NG0117/-/接腳圖/mega pro_pin.jpg

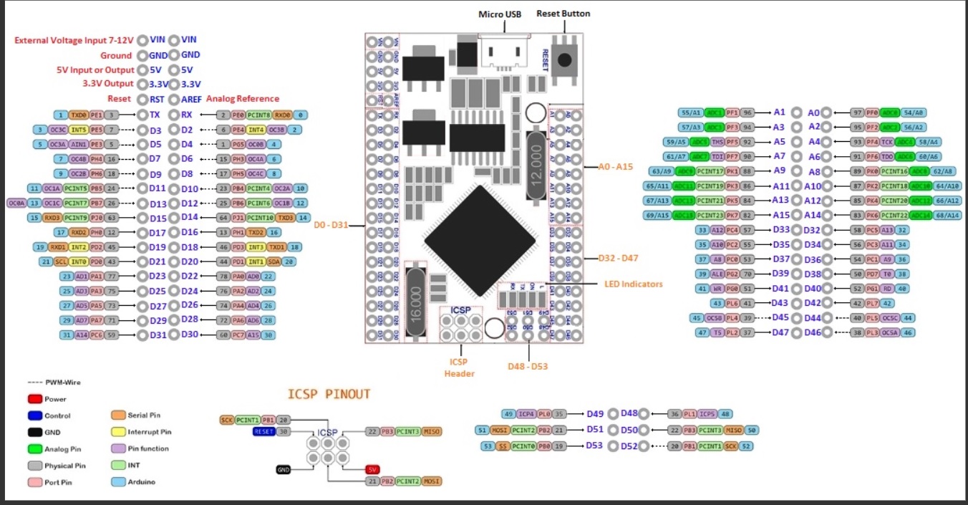
接腳圖/mega pro_pin.jpg
