NG0117/-/接腳圖/ESP32接腳圖.jpg

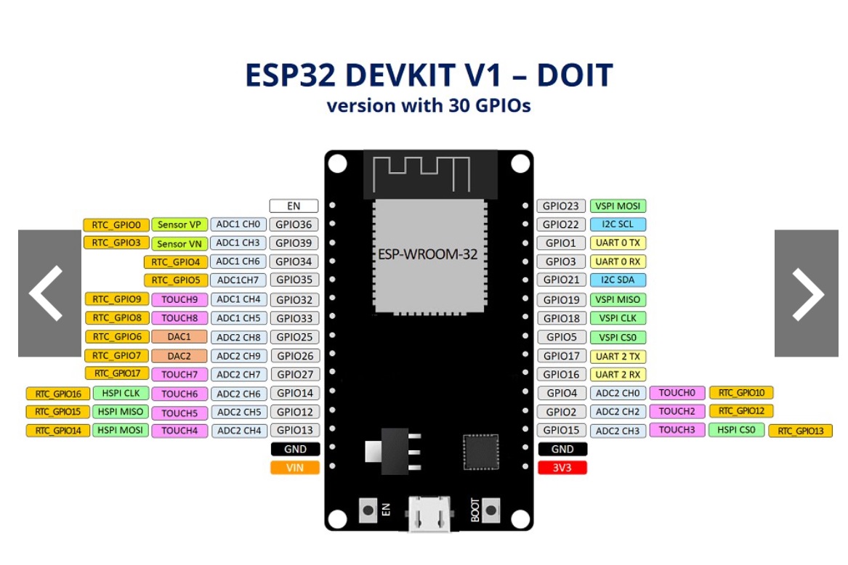
接腳圖/ESP32接腳圖.jpg
