NG0117/-/檔案/報告(Final).pdf

# 中華民國第 61 屆中小學科學展覽會 作品說明書

科 | 別：環境學科
組 | 別：高級中等學校組

## 作品名稱：找出看不見的殺手—空氣汙染監測系統

## 關 鍵 詞：PM2.5、空氣盒子、物聯網

## 指導老師：王彥貿老師、林昭福老師

## 學生班級姓名：鍾恩貴、塗國豪

## 壹、 摘要

邁入高職階段開始學習程式語言以及軟硬體結合應用，在現今資訊科技蓬勃發展的時 代，寫程式變成了當代人必修的課題，搭配這幾年興起的物聯網技術，本研究利用感測器以 及物聯網系統打造出一套簡易的空氣品質監測系統，再加上一個自製的簡易空氣清淨機以用 來來解決室內空氣品質較差的問題。

## 貳、 研究動機

身為土身土長的臺灣人對於空氣汙染一定感同身受，尤其是每年冬天時中南部地區的霾 害尤其嚴重，當然不只冬天，臺灣本地一年四季空氣汙染都很嚴重，我們就以此為靈感來 源，製作出一個可以隨身攜帶的空氣品質監測系統，在空氣汙染過多時提醒我們將口罩戴上 或者避免出門，當然就算是待在室內，空氣品質或多或少還是會受到室外影響，為了解決這 個問題，我們決定製作一個空氣清淨機來解決室內空氣難以流通導致品質較差的問題。

## 參、 研究目的

1. 利用自製的空氣清淨機解決室內空氣品質不良的問題。
2. 利用感測器採樣 co2、pm2.5 等數據做後期採樣分析。
3. 利用測得的數據決定空氣清淨機是否啟動，研究軟硬體的結合。

## 肆、研究設備及器材

項目 | 設備名稱 | 規格 | 數量
1 | Arduino 開發板 | MEGA pro | 1
2 | WiFi 開發板 | ESP32S | 3
3 | PM2.5 模組 | PMS5003GT | 1
4 | 時鐘模組 | DS3231 | 1
5 | SD 卡模組 | HW-125 | 1
6 | 溫溼度模組 | DHT22 | 1
7 | HMI 螢幕 | 3.2 吋 | 1
8 | 藍芽模組 | HC-06 | 1
9 | 升壓模組 | MT3608 | 3
10 | 電源 | 18650 鋰電池 | 2
11 | 空氣品質感測器 | CJMCU-811 | 1
12 | Type C 充電插座 | 6P | 1
13 | 金屬開關 | 2P | 3
14 | CO2 模組 | SenseAirS8 | 1
15 | 記憶卡 | 16GB | 1
16 | PLA 線材 | 1.75mm/1KG | 1
17 | 穩壓模組 | 5V | 1
18 | 繼電器 | 5V | 1
19 | OLED 螢幕 | 1.3 吋 | 1
20 | 風扇 | 12V/4.8A | 1
21 | 活性碳濾網 | | 1
22 | 18650 電池座 | 並聯 2 | 1
23 | 電源接頭 | 2.5mm | 2
24 | 電源插座 | 2.5mm | 1
25 | 電源供應器 | 12V10A | 1

## 伍、研究過程與方法

(一)室內空氣汙染原因及影響
國人每人每天約有 80~90%的時間處在室內環境中(包括在住家、辦公室或其他建築物 內)，室內空氣品質的好壞，直接影響工作品質及效率，因此室內空氣污染物對人體健康影 響應該受到重視。

在密閉的建築物內，如果室內通氣量不足時，污染物就容易蓄積而導致室內空氣品質惡 化。另外，室外的污染物也有可能是影響室內空氣品質的因素，包括戶外汽機車、工廠排放 的廢氣，或是因中央空調冷氣系統的外氣進氣口或濾網未定期清理而孳生的微生物等。台灣 地處亞熱帶，屬於長年潮濕高溫的氣候型態，黴菌及細菌容易孳生，因此必須更注意空調通 風系統的定期維護。

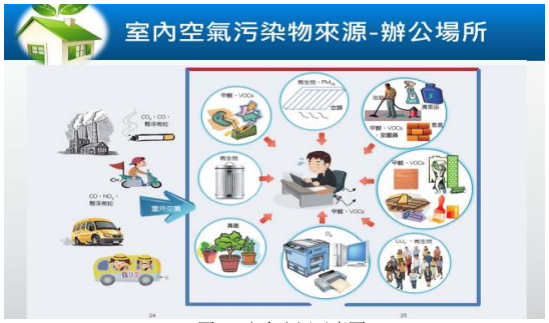
[picture p3: figure]

圖(一)室內空汙示意圖

空氣污染對健康的潛在影響有很多，從身體裡細微的生理變化，以至明顯的病徵如鼻子 及喉嚨癢、氣喘、咳嗽、胸痛或胸悶等。哮喘或慢性呼吸系統疾病患者如接觸到空氣污染 物，病情便會加劇。雖然不同的人受空氣污染影響的程度是取決於不同的因素，但是不同年 齡的人都會受到惡劣的空氣質素的影響，而空氣污染對兒童及長者的影響則更大。

辦公室、教室內二氧化碳濃度會隨著上班、上課時間逐漸累加，當二氧化碳濃度過高 時，除了會刺激呼吸道造成呼吸費力或困難等感覺，也會產生頭痛、嗜睡、倦怠等症狀，因 此若辦公室、教室二氧化碳濃度過高，將會使工作、學習效率降低。

室內二氧化碳濃度過高，最直接的改善方式就是開窗通風，但是常常受限一些因素，例如 外氣空氣品質不佳、噪音、房屋格局等原因而無法開窗，這時可以使用空氣品質偵測系統連 動空氣清淨裝置，淨化室內空氣。

(二)研究過程流程圖

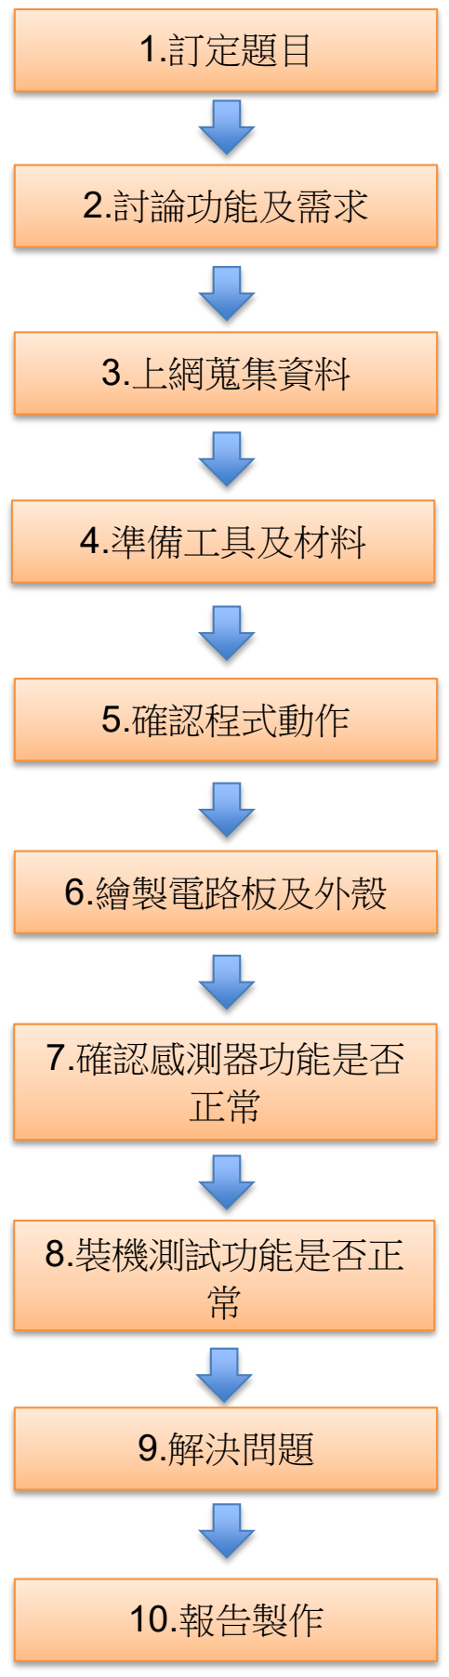
[picture p4: figure]
1.訂定題目; 2.討論功能及需求; 3.上網蒐集資料; 4.準備工具及材料; 5.確認程式動作; 6.繪製電路板及外殼; 7.確認感測器功能是否 正常; 8.裝機測試功能是否正 常; 9.解決問題; 10.報告製作
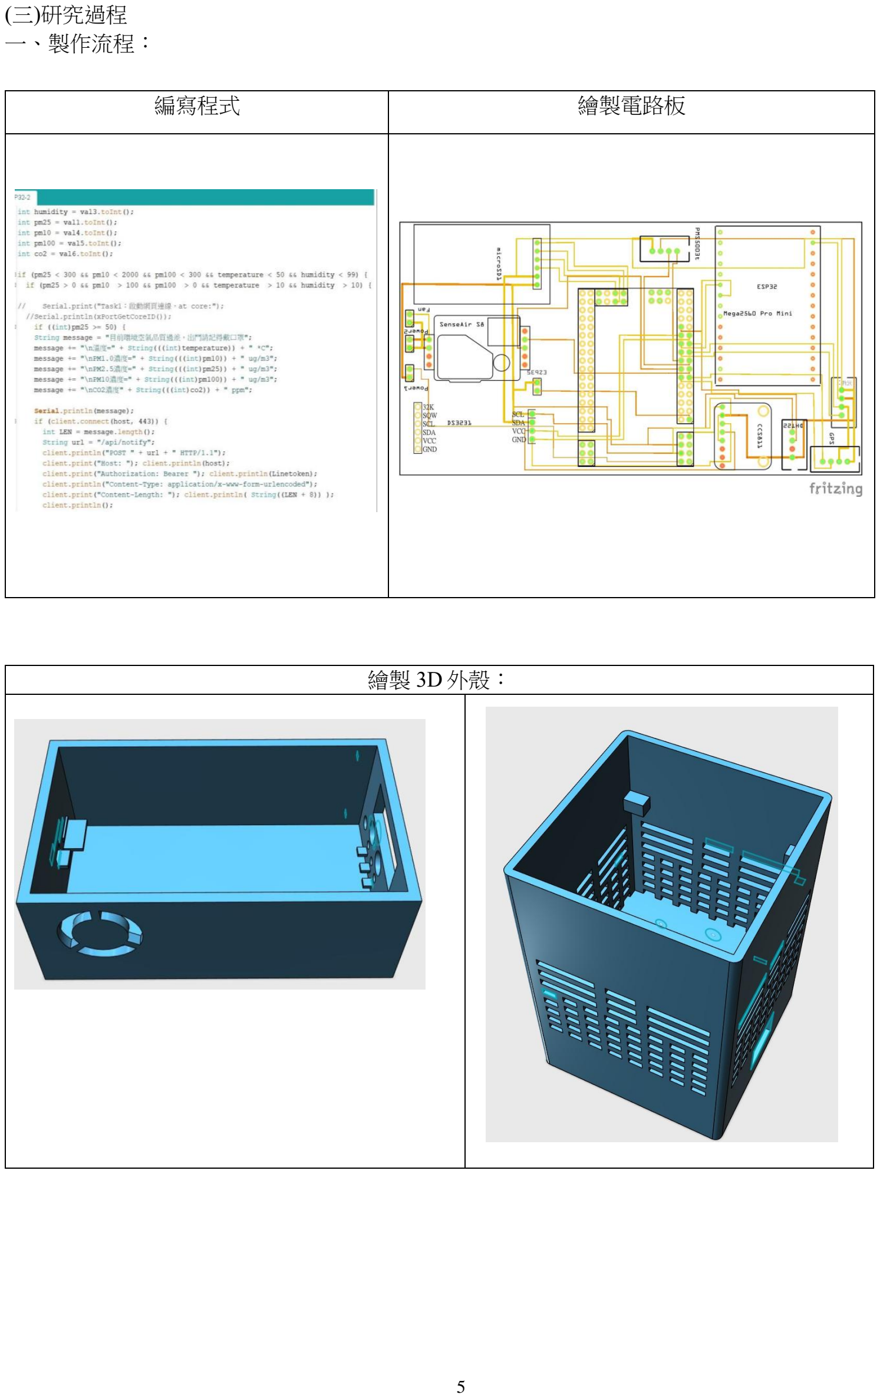
[picture p5: page 6]

(三)研究過程
一、製作流程：
編寫程式 | 繪製電路板

繪製 3D 外殼：

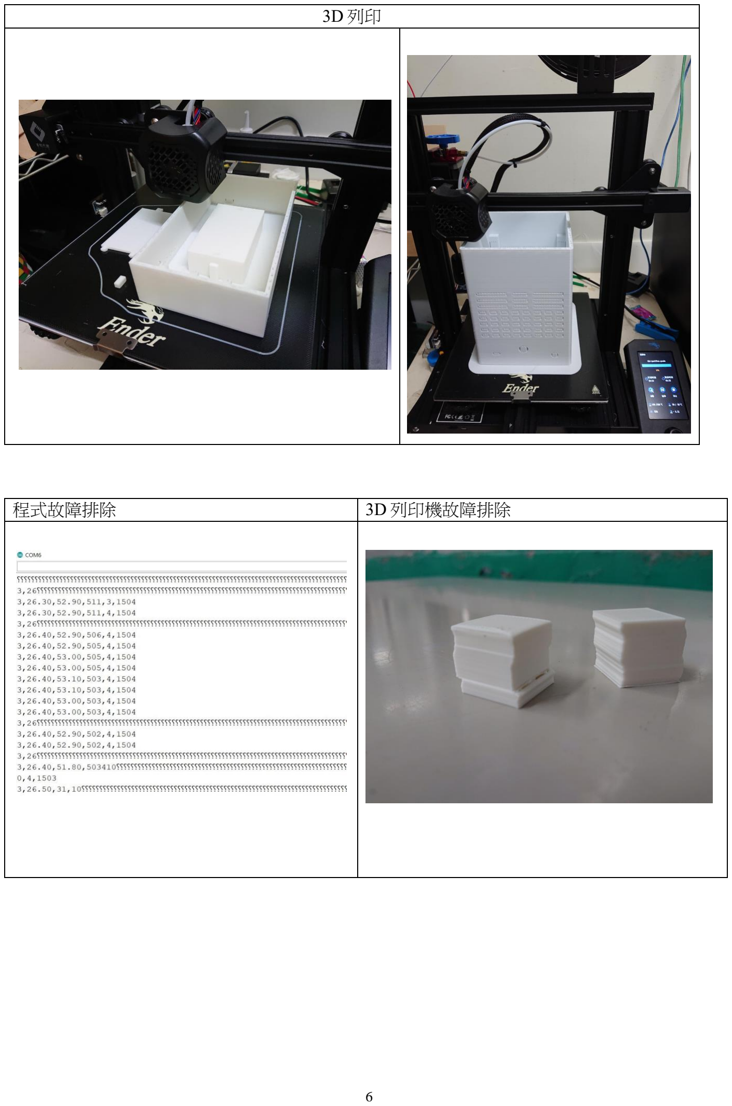
[picture p6: page 7]

程式故障排除 | 3D 列印機故障排除

3D 列印

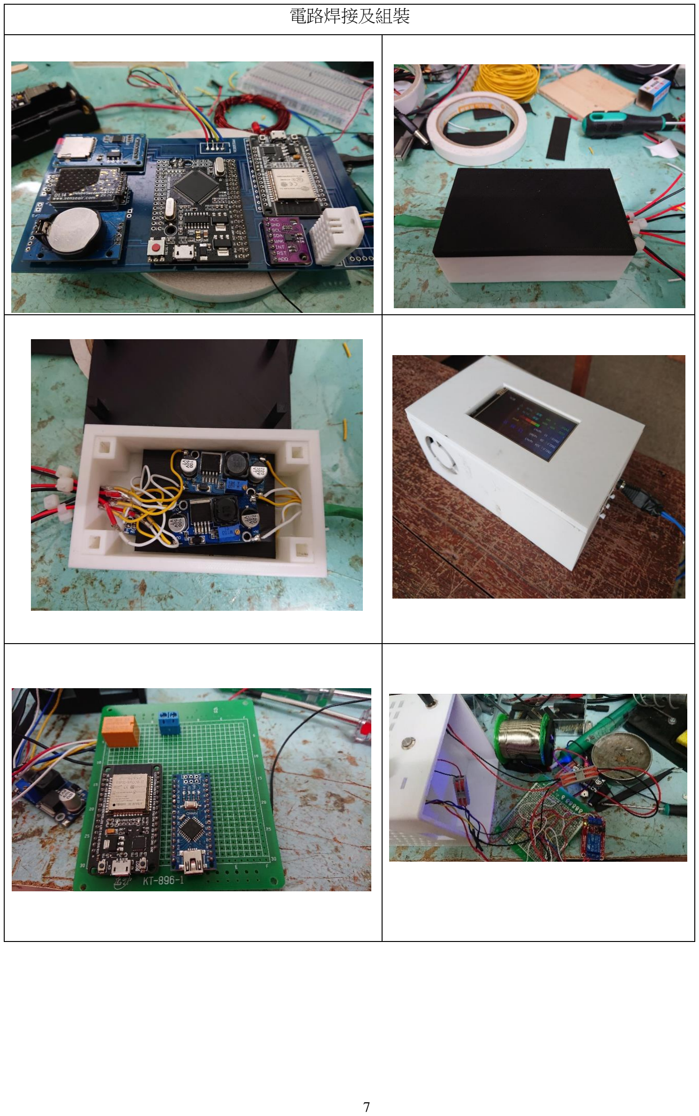
[picture p7: page 8]

電路焊接及組裝

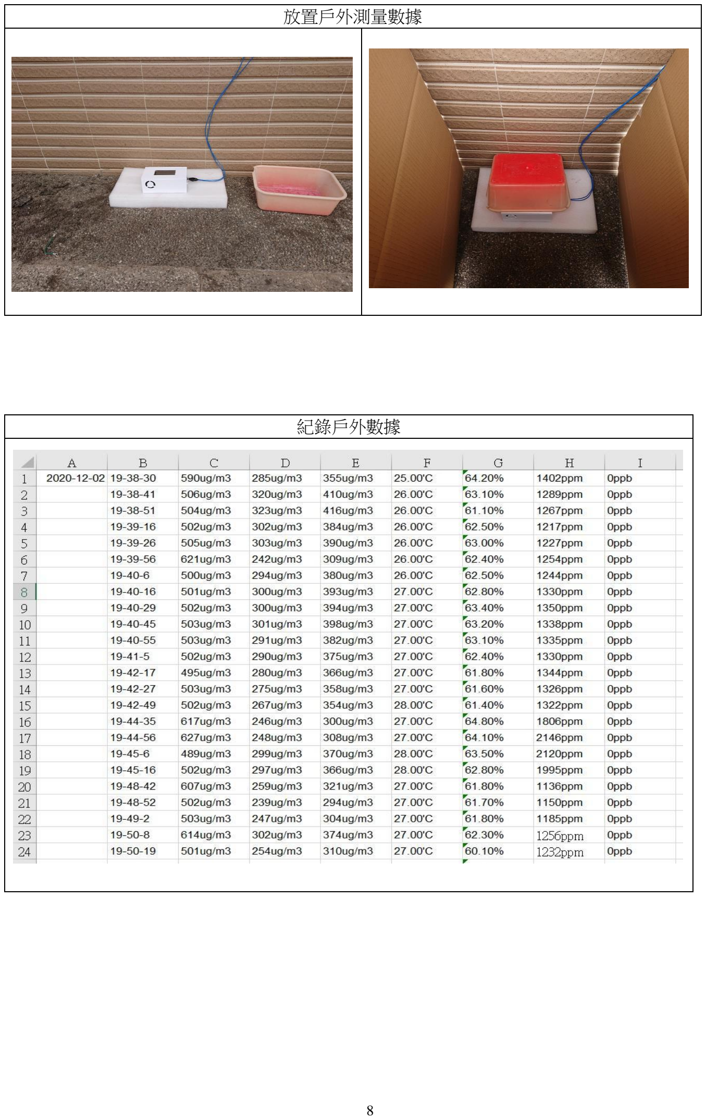
[picture p8: page 9]

放置戶外測量數據

紀錄戶外數據

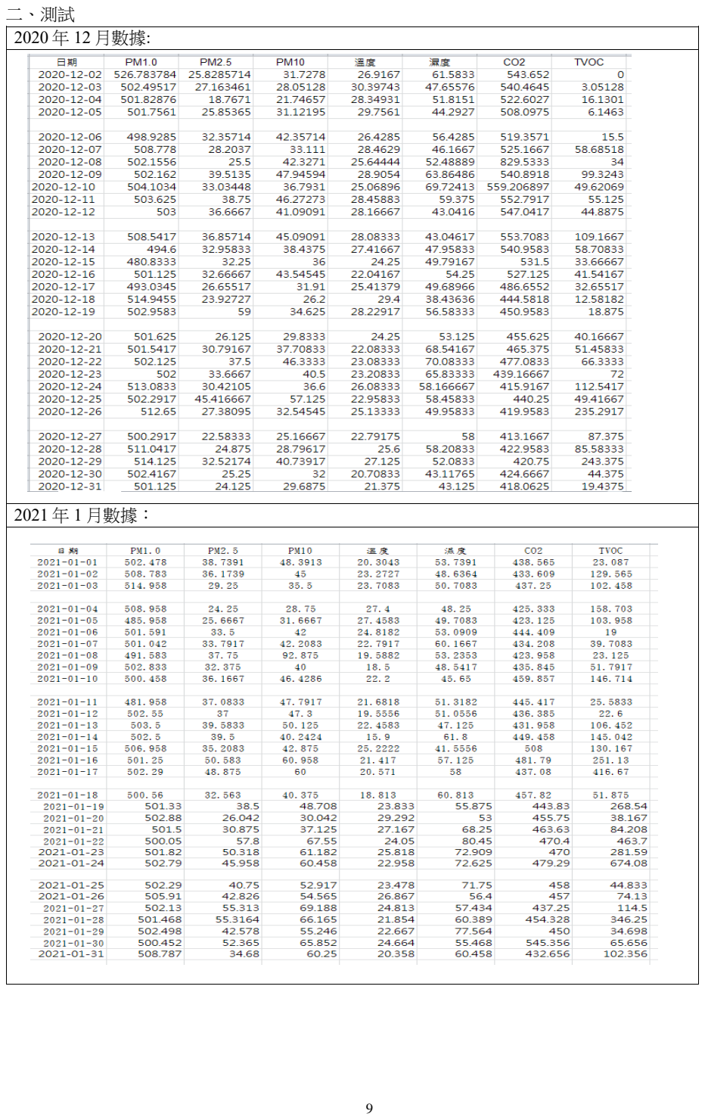
[picture p9: page 10]

二、測試
2020 年 12 月數據:

2021 年 1 月數據：

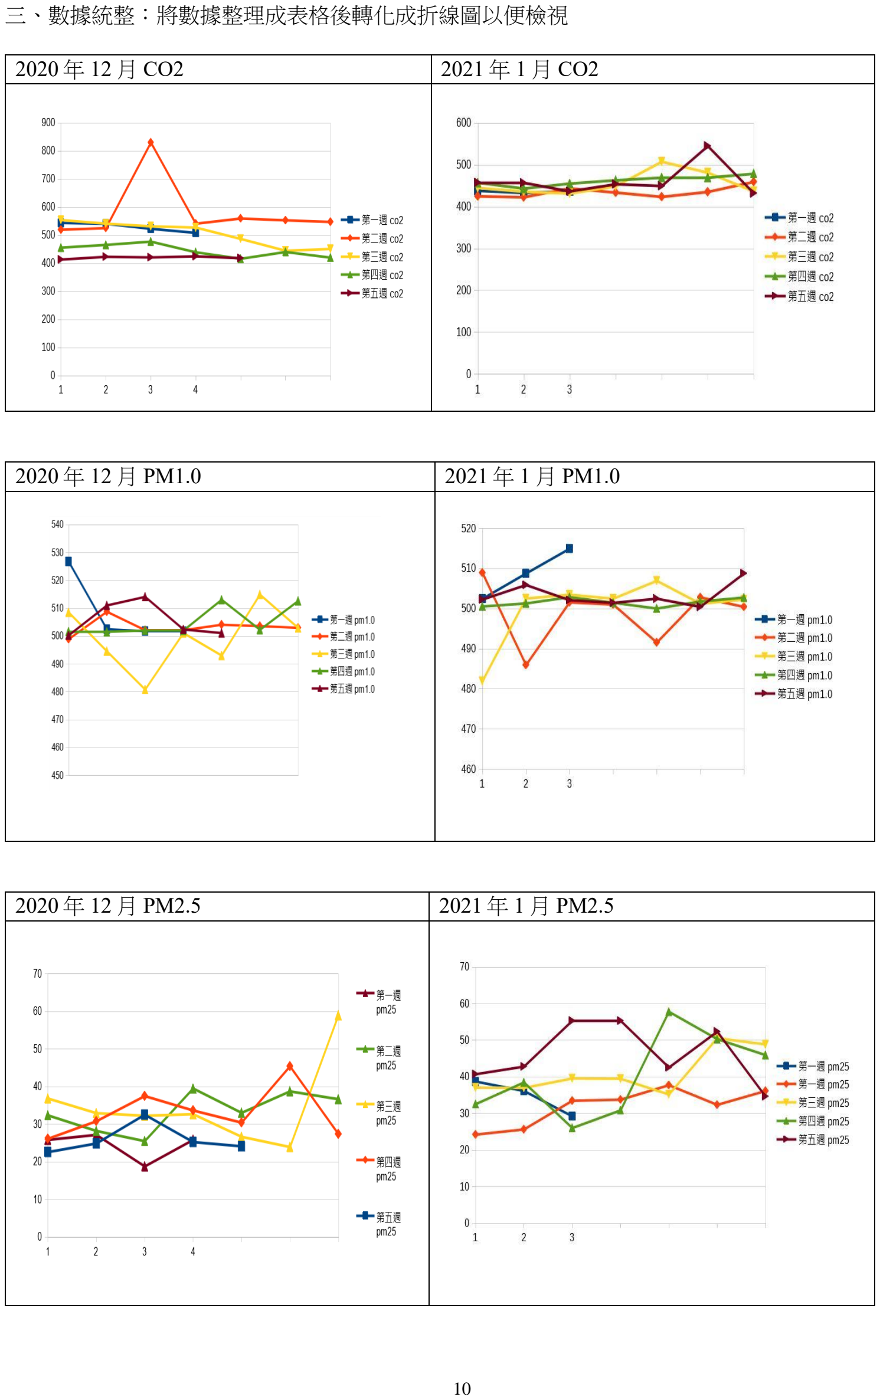
[picture p10: page 11]

三、數據統整：將數據整理成表格後轉化成折線圖以便檢視

2020 年 12 月 CO2 | 2021 年 1 月 CO2
2020 年 12 月 PM1.0 | 2021 年 1 月 PM1.0
2020 年 12 月 PM2.5 | 2021 年 1 月 PM2.5

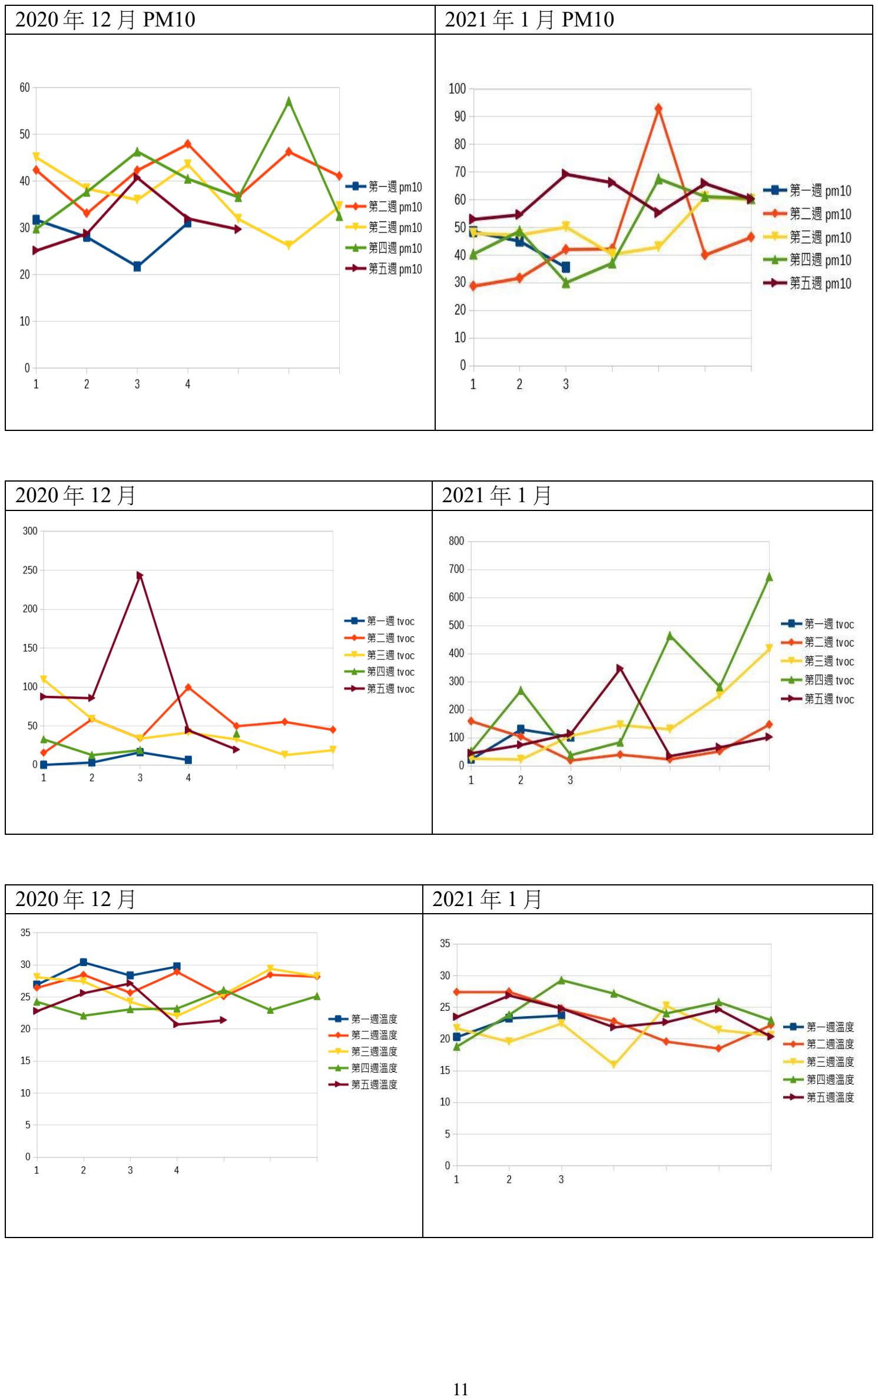
[picture p11: page 12]

2020 年 12 月 PM10 | 2021 年 1 月 PM10
2020 年 12 月 | 2021 年 1 月
2020 年 12 月 | 2021 年 1 月

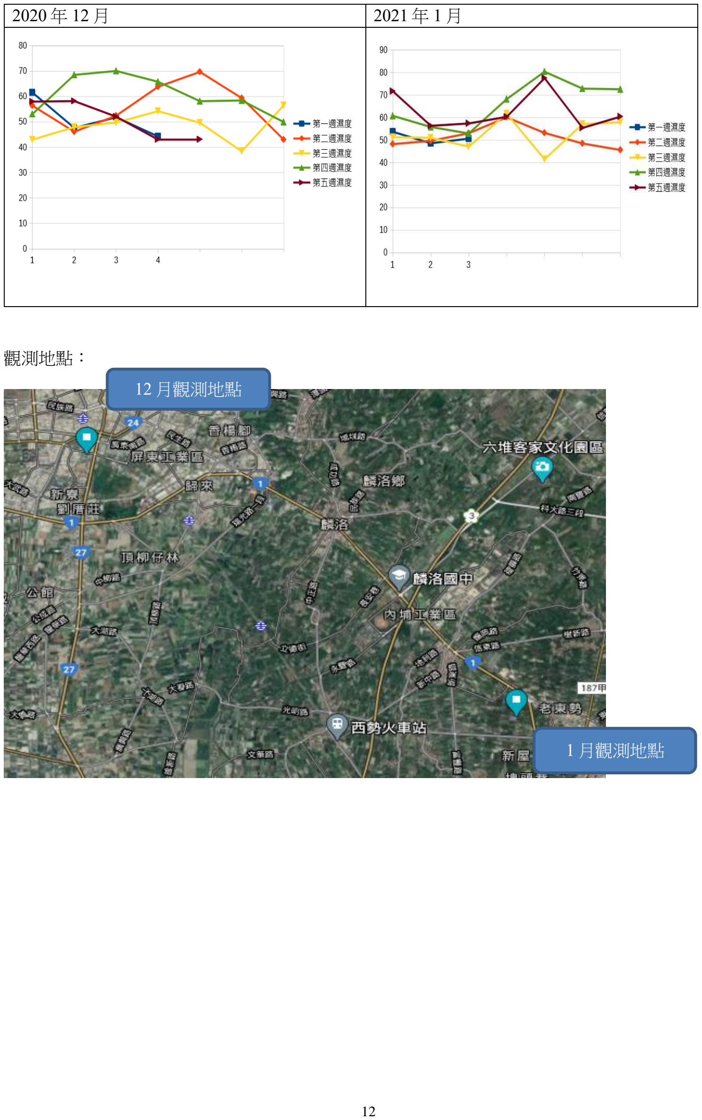
[picture p12: page 13]

2020 年 12 月 | 2021 年 1 月

觀測地點：

12 月觀測地點

1 月觀測地點

各國空汙標準數據，以歐盟、美國、臺灣為標準：

PM2.5 標準：(以 24 小時平均值為基準) | PM10 標準(以 24 小時平均值為基準)
國家 | 數值 | 單位
美國 | 35 | µg/m³
歐盟 | 25 | µg/m³
臺灣 | 35 | µg/m³

CO2 標準：
CO2 濃度 | 對健康影響
400ppm | 室外環境空氣
650ppm | 室內通風空氣佳
850ppm | 開始覺得空氣有點悶
1000ppm | 國家室內空氣品質標準
2500ppm | 對健康造成影響(頭痛、嗜睡)
5000ppm | 不宜在此環境待超過 8 小時
15000ppm | 有急性死亡危險，馬上離開此環境

實驗結果：
就觀測的結果得之 12 月及 1 月 PM2.5 濃度均超過臺灣 PM2.5 之標準值，所以空氣品質 並不優良。本實驗測試之時間為冬季，因為時間的關係，未來會在其他季節也加入實驗，讓 空汙監測的數據庫更加完整，才能提供更高的可信度。
國家 | 數值 | 單位
美國 | 150 | µg/m³
歐盟 | 50 | µg/m³
臺灣 | 100 | µg/m³

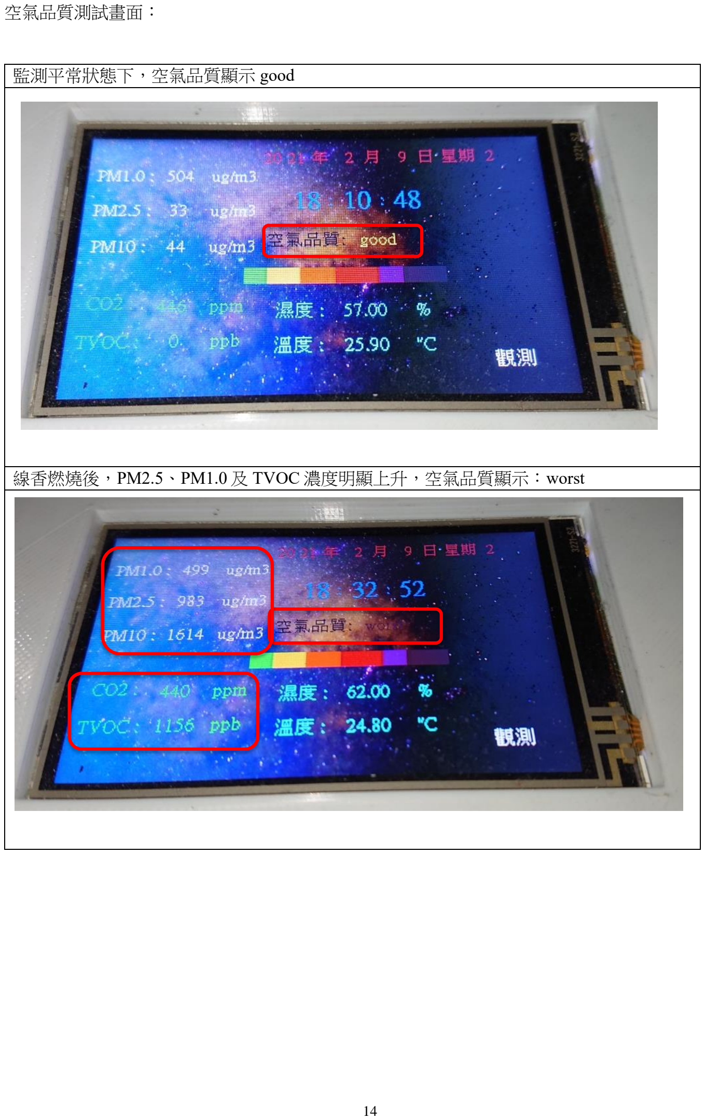
[picture p13: page 15]

空氣品質測試畫面：

監測平常狀態下，空氣品質顯示 good

線香燃燒後，PM2.5、PM1.0 及 TVOC 濃度明顯上升，空氣品質顯示：worst

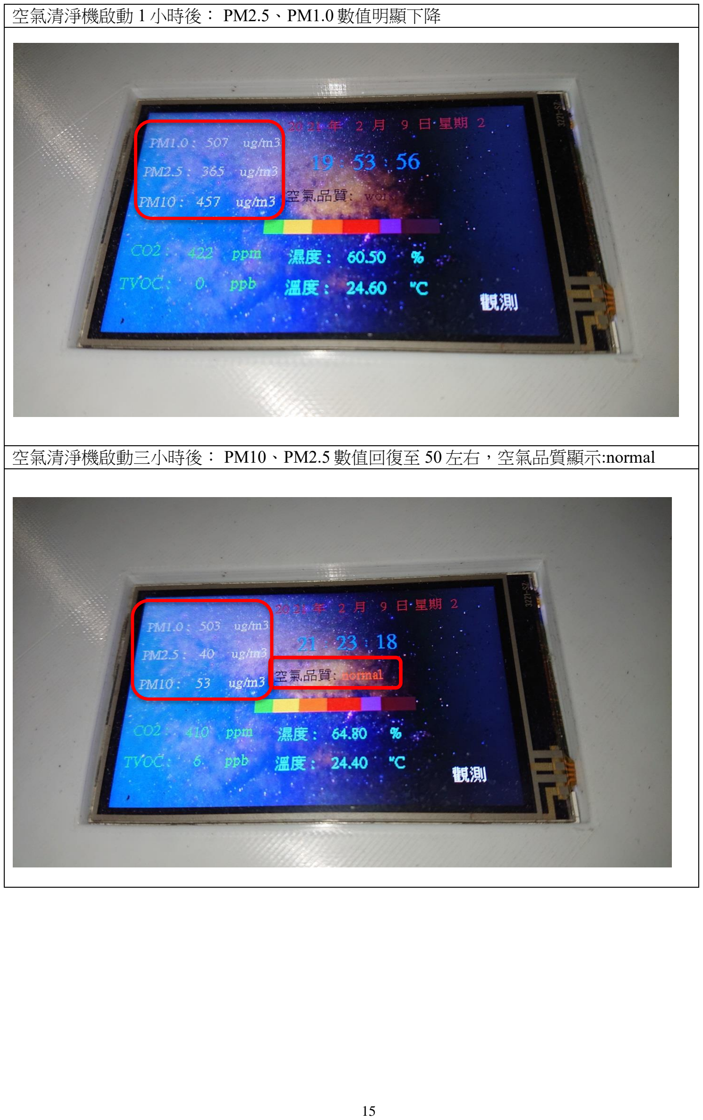
[picture p14: page 16]

空氣清淨機啟動 1 小時後： PM2.5、PM1.0 數值明顯下降

空氣清淨機啟動三小時後： PM10、PM2.5 數值回復至 50 左右，空氣品質顯示:normal

## 陸、成品

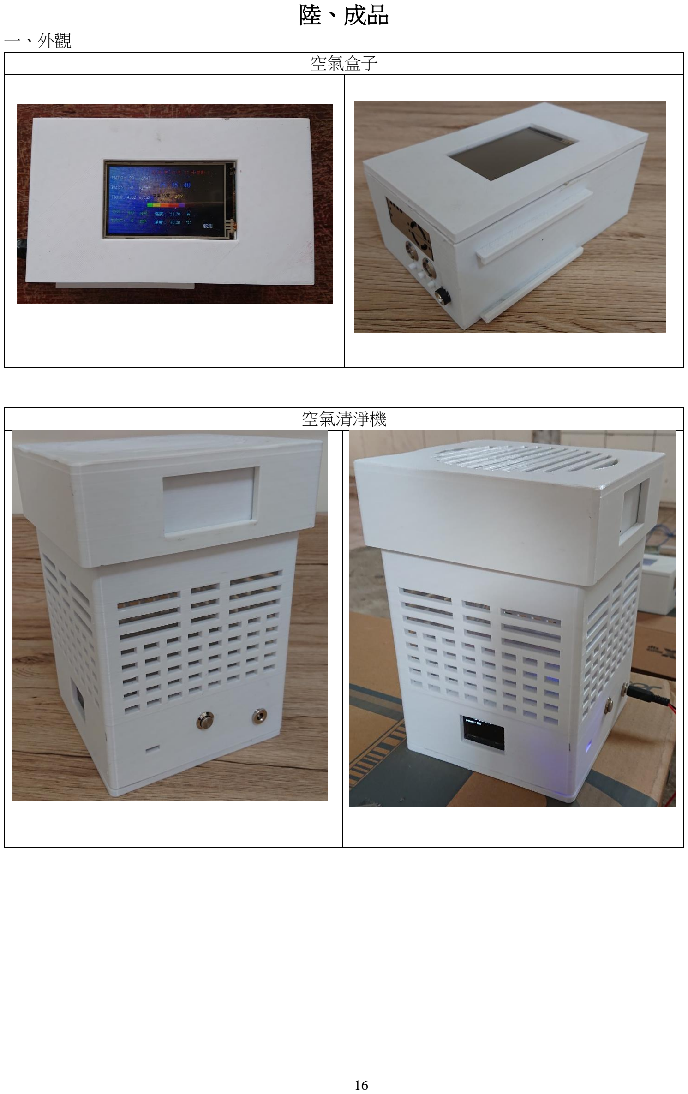
[picture p15: page 17]

一、外觀
空氣盒子

空氣清淨機

二、程式

#include "DHT.h"

#define DHTPIN 22 // what pin we're connected to #define DHTTYPE DHT22 // DHT 22 (AM2302) #define fan 4

int maxHum = 60;
int maxTemp = 40;

DHT dht(DHTPIN, DHTTYPE);

void setup() {
pinMode(fan, OUTPUT);
Serial.begin(9600);
dht.begin();
}

void loop() {
// Wait a few seconds between measurements. delay(1000);

// Reading temperature or humidity takes about 250 milliseconds!
// Sensor readings may also be up to 2 seconds 'old' (its a very slow sensor)
float h = dht.readHumidity();
// Read temperature as Celsius
float t = dht.readTemperature();

// Check if any reads failed and exit early (to try again).
if (isnan(h) || isnan(t)) {
Serial.println("Failed to read from DHT sensor!"); return;
}

if(h > maxHum || t > maxTemp) { digitalWrite(fan, HIGH);
} else {
digitalWrite(fan, LOW);
}

Serial.print("Humidity: "); Serial.print(h);
Serial.print(" %\t");
Serial.print("Temperature: "); Serial.print(t);
Serial.println(" *C ");

}

接收感測器溫溼度值

readData.check();
int lastcommaPos;
int commaPos = Read.indexOf(',', 0); // find first comma
String val1 = Read.substring(0, commaPos); // grab first value
lastcommaPos = commaPos + 1;
commaPos = Read.indexOf(',', lastcommaPos); // find next comma
String val2 = Read.substring(lastcommaPos, commaPos); // grab next value
lastcommaPos = commaPos + 1;
commaPos = Read.indexOf(',', lastcommaPos); // find next comma
String val3 = Read.substring(lastcommaPos, commaPos); // grab next value
lastcommaPos = commaPos + 1;
commaPos = Read.indexOf(',', lastcommaPos); // find next comma
String val4 = Read.substring(lastcommaPos, commaPos); // grab next value
lastcommaPos = commaPos + 1;
commaPos = Read.indexOf(',', lastcommaPos); // find next comma
String val5 = Read.substring(lastcommaPos, commaPos); // grab next value
lastcommaPos = commaPos + 1;
commaPos = Read.indexOf(',', lastcommaPos); // find next comma
String val6 = Read.substring(lastcommaPos, commaPos); // grab next value

int temperature = val2.toInt(); int humidity = val3.toInt(); int pm25 = val1.toInt();
int pm10 = val4.toInt();
int pm100 = val5.toInt();
int co2 = val6.toInt();

接收 Mega 板資料並傳送至 Thingspeak 網站

#include <SPI.h>

#include <SD.h>

File myFile;
String filename = "test.csv"; //要寫入的檔案 名稱

void setup() {
pinMode(53,OUTPUT); | //保留 pin10,
SD Library 需要使用
while (!SD.begin(4)) {}
Serial.begin(9600);
}

void loop()
{
float timesec= millis()/1000.0; | //目前時
間，單位是"秒"
char timesecstr[6];
dtostrf(timesec,3, 3, timesecstr); Serial.print(timesecstr);

myFile = SD.open(filename, FILE_WRITE); if (myFile) {
Serial.print("Writing to test.txt...");
myFile.print(timesecstr); | //寫入時間
myFile.print(","); | //之後每個數據
之間加入逗號","

myFile.print("testing123"); //要寫偵測 數據時，這一行請換掉
myFile.print(","); | //每個數據之間
加入逗號","
myFile.print("123");
myFile.println();
myFile.close(); | //關閉檔案
Serial.println("done.");
} else {
Serial.println("error opening test.txt"); }
}

寫入監測資料至 SD 卡

動作說明:

簡易動作流程:

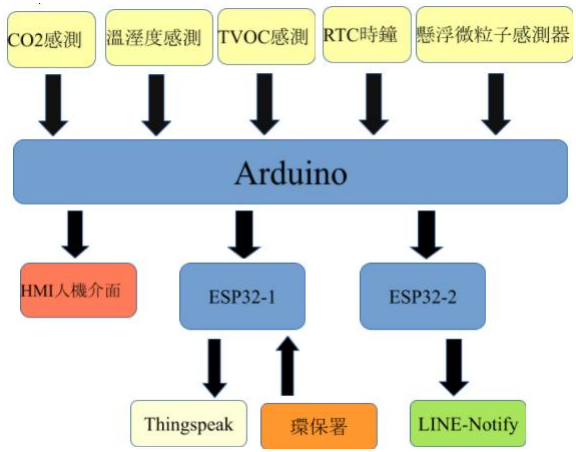
[picture p16: figure]

(一).螢幕顯示
將空氣盒子收集到的數據顯示至螢幕上
在螢幕上可顯示:
PM1.0、PM2.5、PM10CO2、TVOC、溫度、濕度以及時間 若是有連網時點下觀測即可及時看到該地區環保署即時監測數據

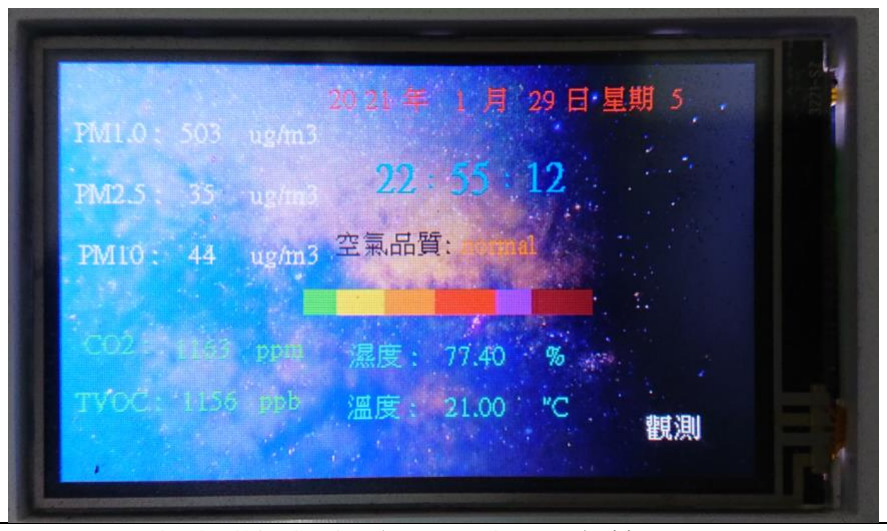
[picture p17: figure]

有連網時點下觀測即可及時看到該地區環保署即時監測數據

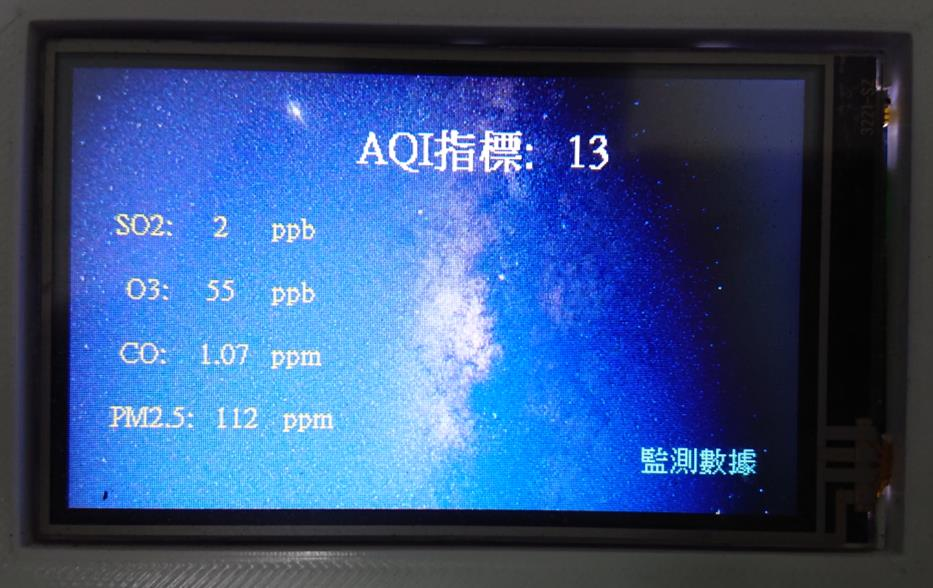
[picture p18: figure]

此頁面可觀看自環保署即時 PM2.5、 AQI 指標、SO2 濃度、臭氧濃度、CO 濃度 數據

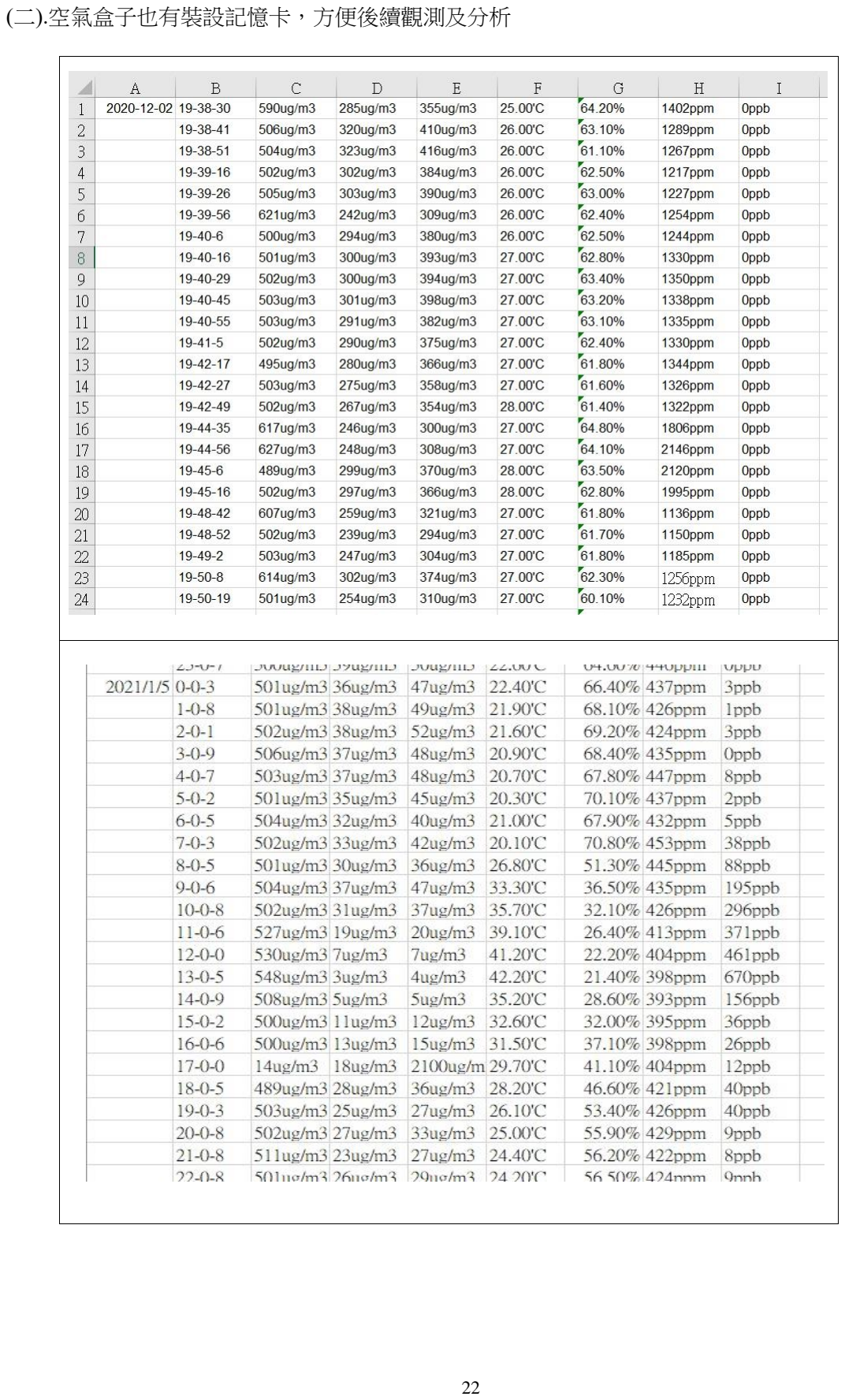
[picture p19: page 23]

(二).空氣盒子也有裝設記憶卡，方便後續觀測及分析

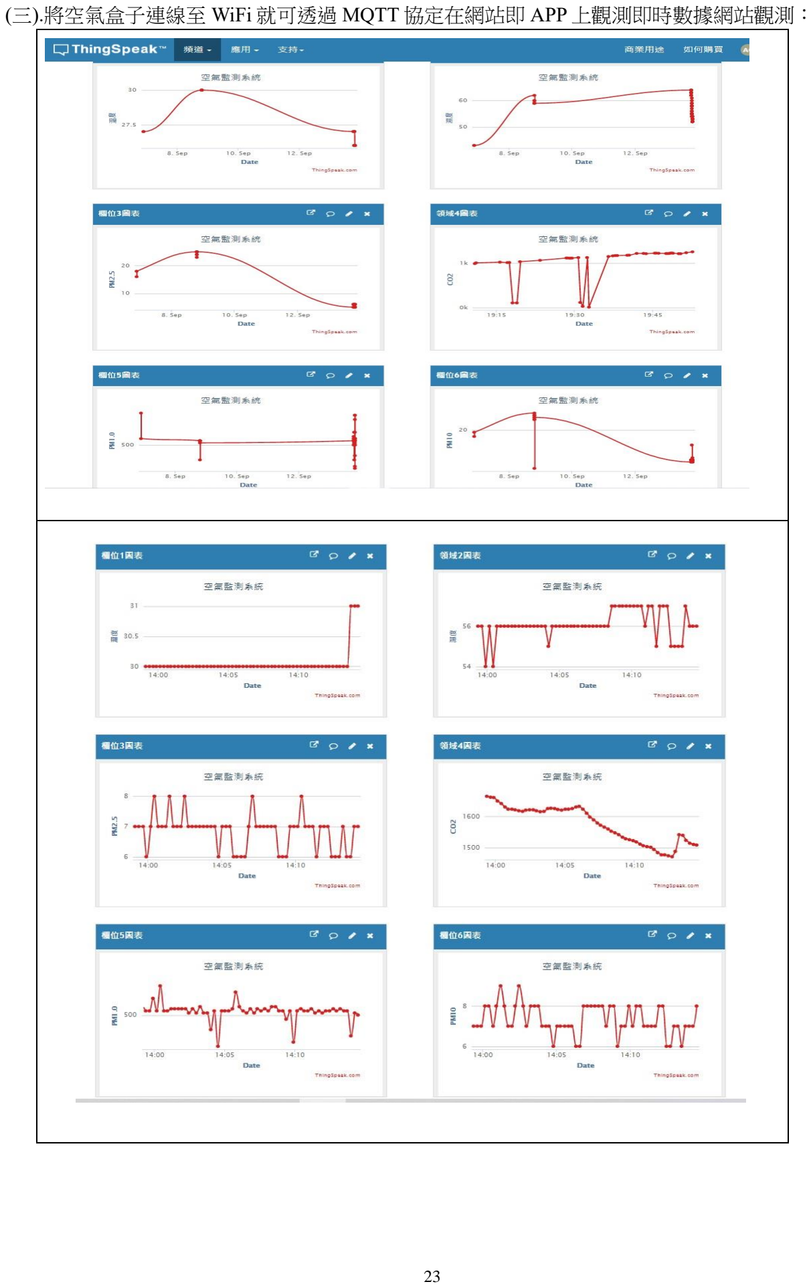
[picture p20: page 24]

(三).將空氣盒子連線至 WiFi 就可透過 MQTT 協定在網站即 APP 上觀測即時數據網站觀測：

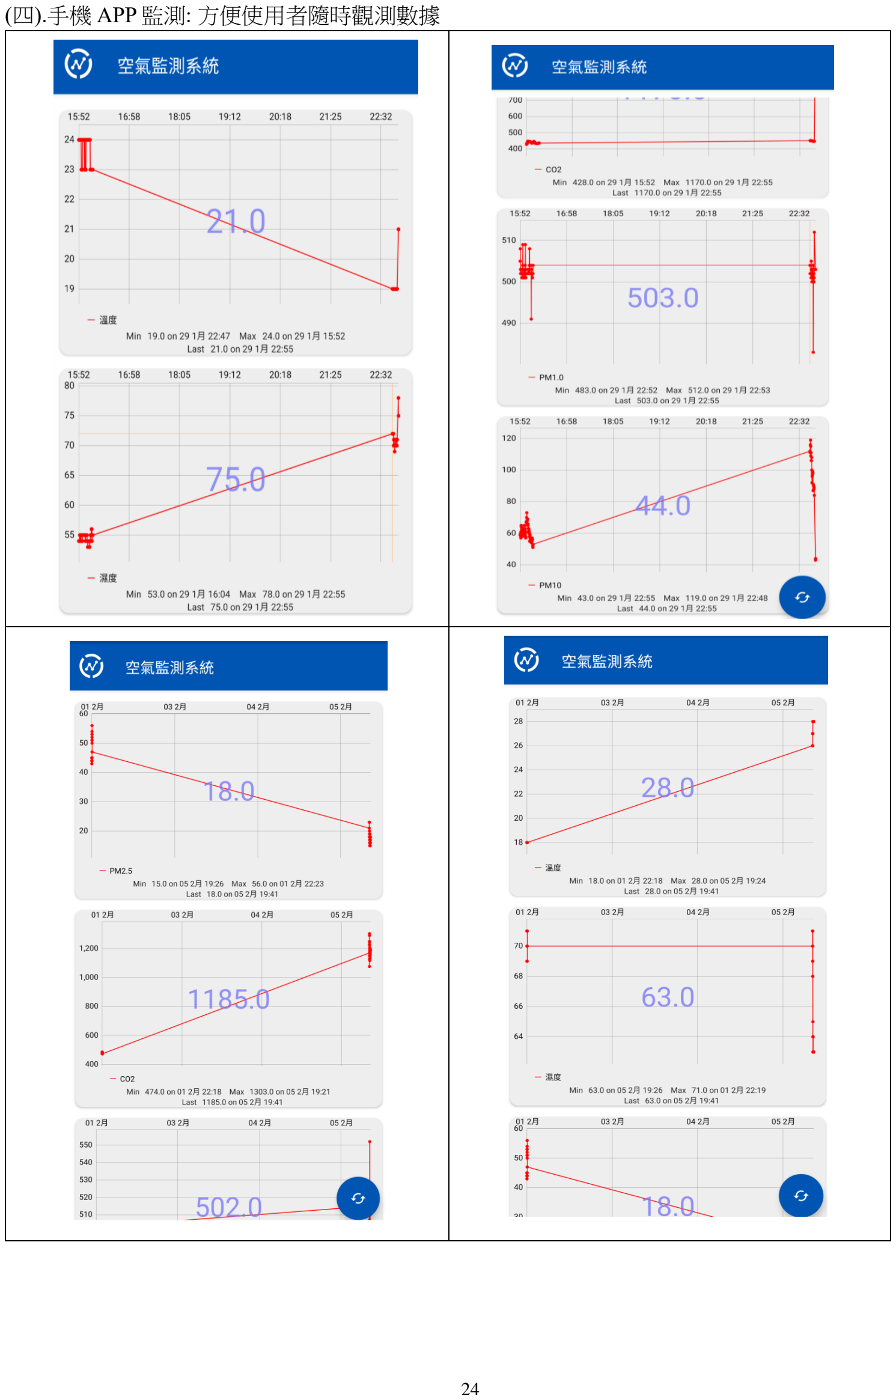
[picture p21: page 25]

(四).手機 APP 監測: 方便使用者隨時觀測數據

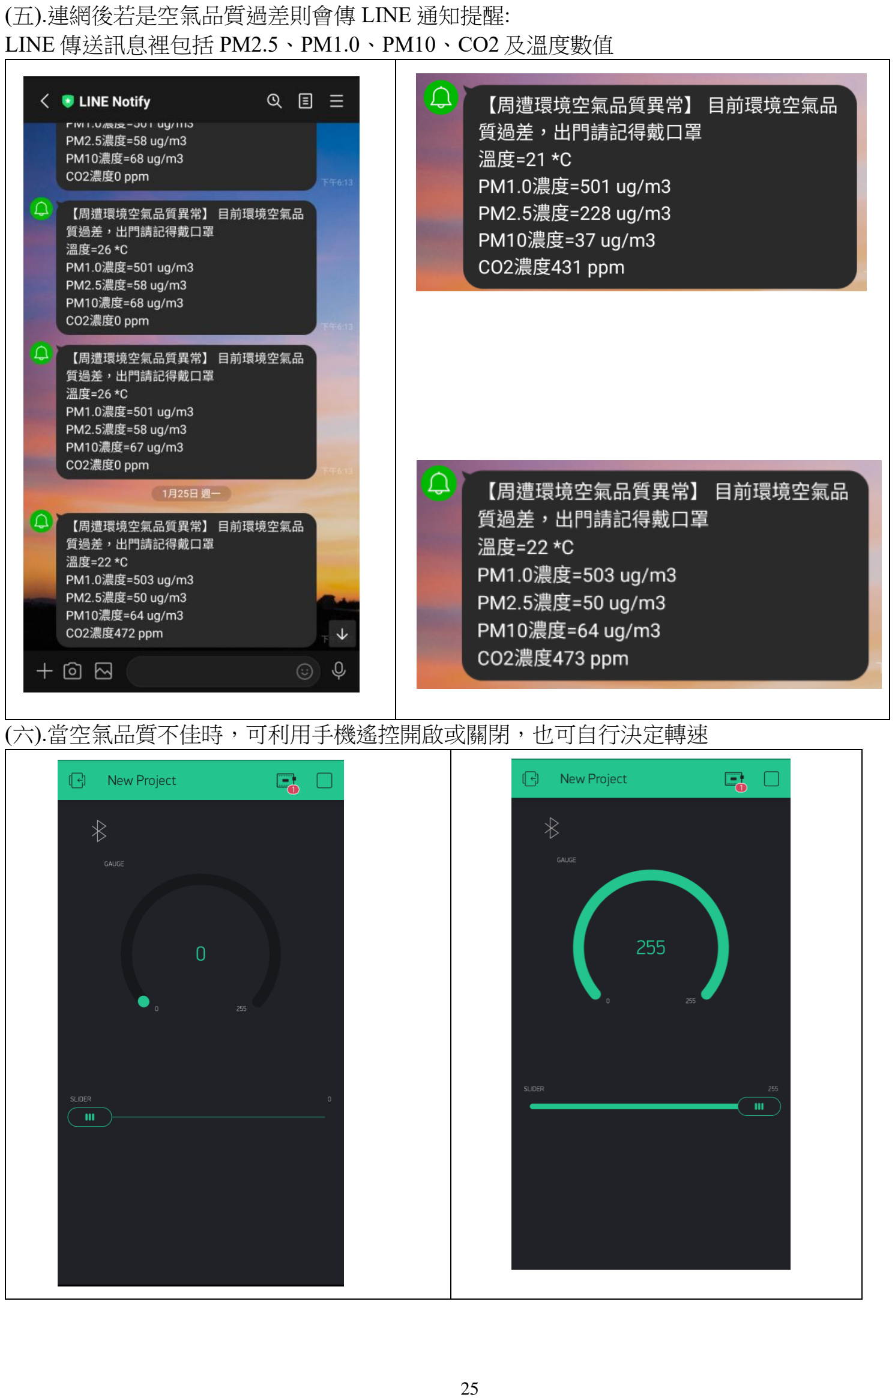
[picture p22: page 26]

(五).連網後若是空氣品質過差則會傳 LINE 通知提醒: LINE 傳送訊息裡包括 PM2.5、PM1.0、PM10、CO2 及溫度數值

(六).當空氣品質不佳時，可利用手機遙控開啟或關閉，也可自行決定轉速

## 柒、結論

1. 就觀測的數據得知屏東縣 1 月的空氣品質較 12 月差。
2. 目前本實驗均為定點監測，未來希望可以將空氣盒子做得便於攜帶，以利隨時得知當下 所處空間之空氣品質狀況。
3. 藉由 SD 卡可將數據儲存起來，以便於未來需要分析數據時使用。
4. 實驗空汙監測數據均能透過物聯網的方式投放至網路上以便他人參考。
5. 本研究目前所測試的地點及時間皆有限制，未來希望可擴大範圍以獲得更全面性的數據。

## 捌、參考資料

[1]行政院環境保護署-室內空氣品質資訊網 https://iaq.epa.gov.tw/indoorair/page/News_6_1.aspx [2]二氧化碳對人體的影響-欣寶智慧環境 http://www.newgreentech.com.tw/news/detail/21 [3]JetAIR 空氣清淨機 DIY 開發全記 https://www.mobile01.com/topic detail.php?f=731&t=5346 [4]https://howtomechatronics.com/projects/diy-air-quality-monitor-pm2-5-co2-voc-ozone-temp-hum- arduino-meter
[5]環保署環境資料開放平台 https://opendata.epa.gov.tw/
[6] https://youyouyou.pixnet.net/blog/post/120275941%E7%AC%AC%E5%8D%81%E5%9B%9B%E7%AF%87esp32wifiserver%E7%B6%B2%E9%A0%81%E4%BC%BA% E6%9C%8D%E5%99%A8%28%E9%81%A0% E7%AB%AF%E6% BE%86%E8 %8A%B1
[7] https://howtomechatronics.com/projects/diy-air-quality-monitor-pm2-5-co2-voc-ozone-temp-hum- arduino-meter/
[8]https://hackmd.io/dI3JbO9mSf6bkMMV2eXn0w?view&fbclid=IwAR1nPBsdCpmnPcZAQe8A ODstxpF-5LyBfQUp5QbKcT1gPvoHJn-513O050E#2-HTPPSRedirectcpp-%E9%83%A8% E5%88%86
[9] https://randomnerdtutorials.com/esp8266-weather-forecaster/
[10] https://roboindia.com/tutorials/nodemcu-weather-station-arduino/
[11] https://youtu.be/dg5AGauOW7Y
[12]圖(1)擷取自 http://www.jsene.com/Tainan_EPB/IA Q/custfiles/files/105%E5%B9%B4%E 5%BA% A6IAQ%E8%AA%AA%E6%98%8E%E6%9C%83%E7%B0%A1%E5% A0%B1% E5%A E%A4% E5%85%A7%E7%A9%BA%E6%B0%A3%E5%93%81%E8% B3%AA %E6%B1%A1%E6%9F%E6%A4%8D%E6%A0%BD%E5%AE%A3%E5 %B0%8E(%E8%A8%B1%E8%80%81%E5%B8%AB)-%E7%A2%BA%E5%AE%9A.pdf
