NG0117/-/接腳圖/4線風扇接腳.png

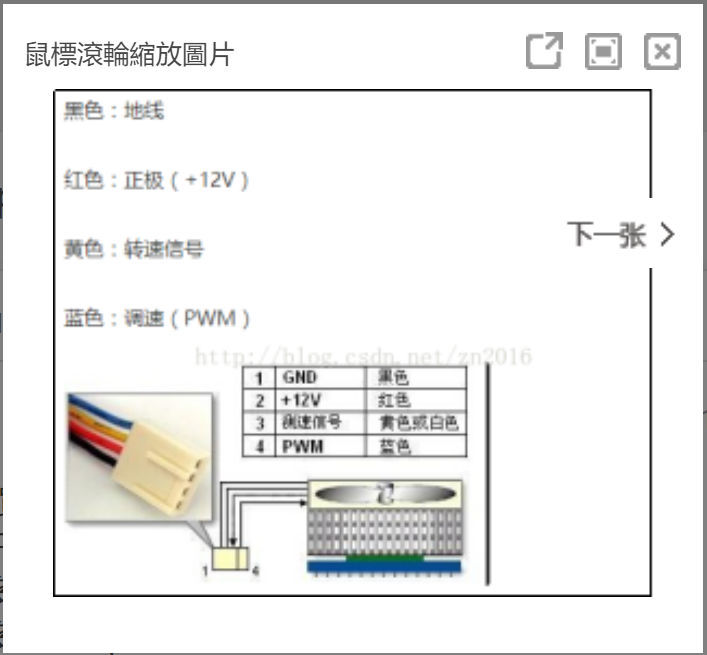
接腳圖/4線風扇接腳.png
