NG0117/-/接腳圖/SenseAir S8_Pin.png

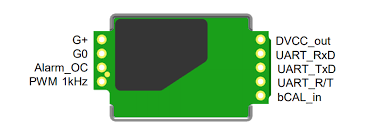
接腳圖/SenseAir S8_Pin.png
