NG0117/-/外觀/power_box.stl

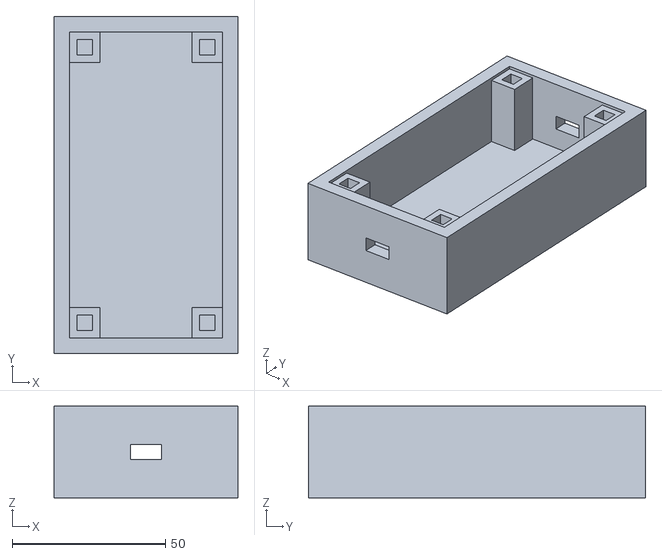
[picture p25: CAD file, 2024-07-21]
外觀/power_box.stl
60.0 x 110.0 x 30.0
