NG0117/-/外觀/shell.stl

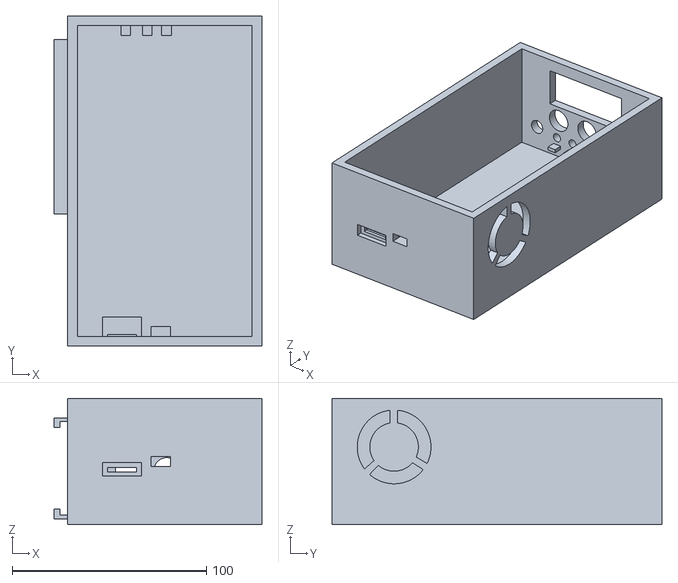
[picture p26: CAD file, 2024-07-21]
外觀/shell.stl
107.0 x 170.0 x 65.0
