NG0117/-/外觀/push.stl

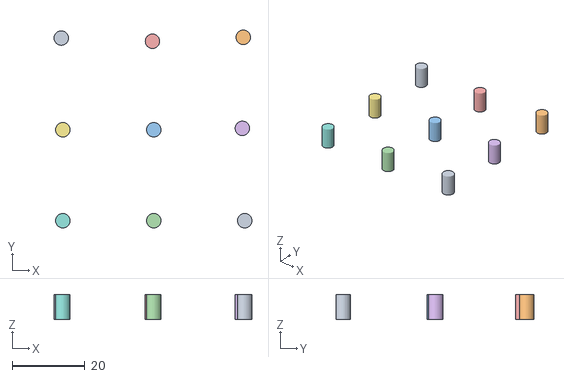
[picture p27: CAD file, 2024-07-21]
外觀/push.stl
54.4 x 54.4 x 7.00
