NG0117/-/外觀/power_cover.stl

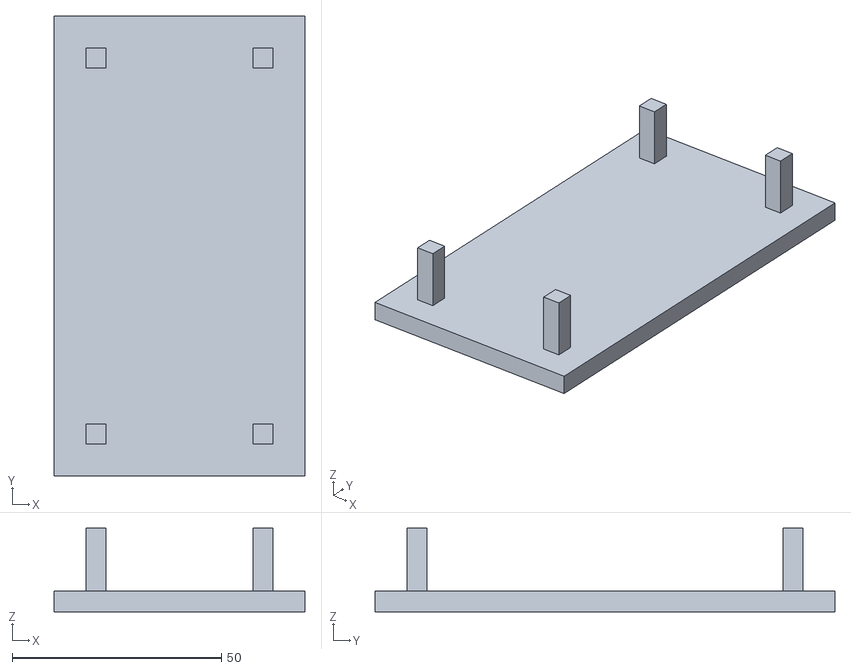
[picture p28: CAD file, 2024-07-21]
外觀/power_cover.stl
60.0 x 110.0 x 20.0
