NG0117/-/外觀/Air-purifier.stl

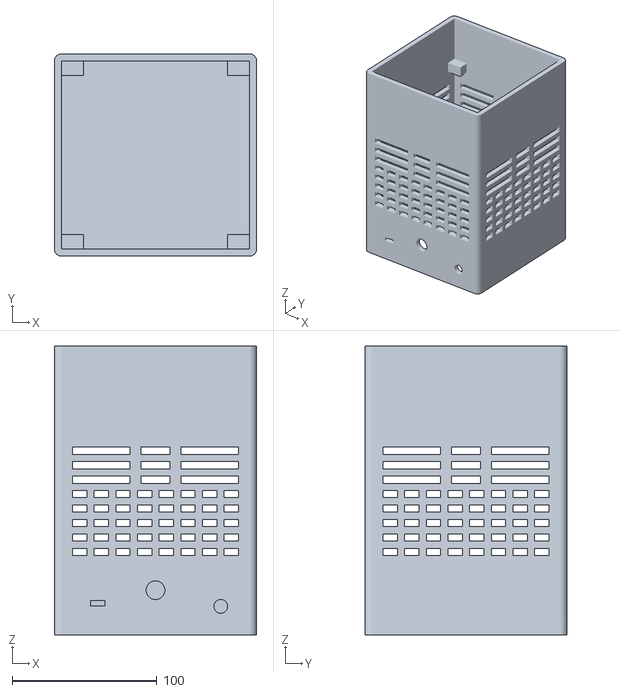
[picture p29: CAD file, 2024-07-21]
外觀/Air-purifier.stl
140.0 x 140.0 x 200.0
