NG0117/-/外觀/battery.stl

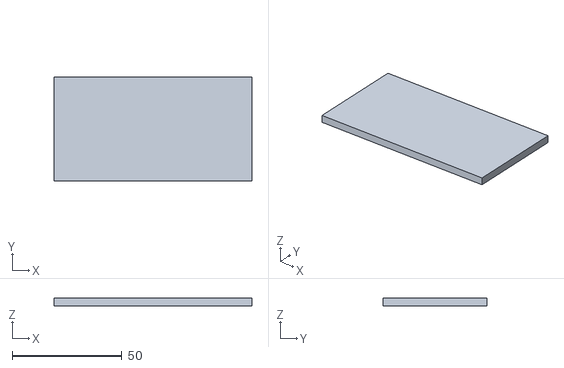
[picture p30: CAD file, 2024-07-21]
外觀/battery.stl
90.0 x 47.5 x 3.50
