NG0117/-/外觀/cleaner-cover.stl

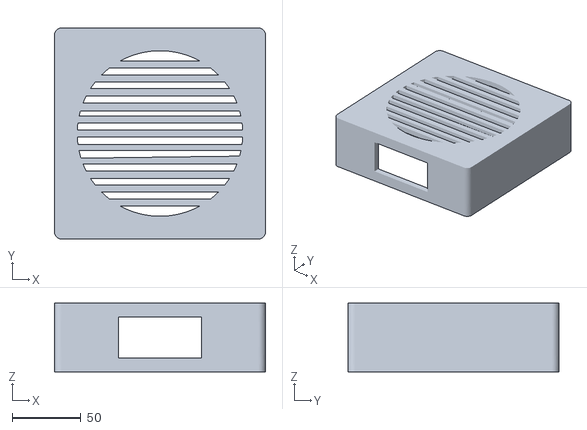
[picture p31: CAD file, 2024-07-21]
外觀/cleaner-cover.stl
153.0 x 153.0 x 50.0
