NG0117/-/外觀/cover.stl

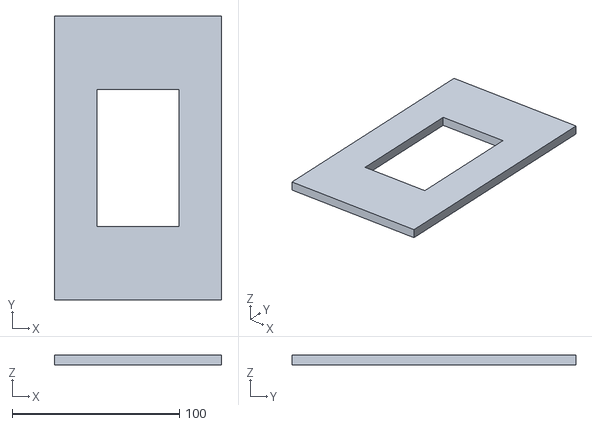
[picture p32: CAD file, 2024-07-21]
外觀/cover.stl
100.0 x 170.0 x 6.00
