NG0117/-/(list of files, drawings)

Other design files:
接腳圖/project.fzz
