NG0117/-/(commit log)

2024-07-21 Add files via upload
    3D模型外觀設計
    [Air-purifier.stl, battery.stl, cleaner-cover.stl, cover.stl, power_box.stl, power_cover.stl, push.stl, shell.stl]
2024-07-21 Add files via upload
    主要用到一塊Arduino mega pro mini 、2塊ESP32做為主要控制，在外接一個控制Blynk的ESP32以及一個空氣清淨機控制板
2024-07-21 Add files via upload
    這次使用fritzing作為繪製電路版軟體
    [project.fzz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]
2024-07-21 Add files via upload
    監測數據資料
2024-07-21 Add files via upload
    人機介面設定
